DanielMBouyou/AetherArray/hardware/rev-a/erc/erc-report.txt

ERC report (2026-09-18T19:03:25, Encoding UTF8)
Report includes: Errors, Warnings, Exclusions

***** Sheet /

***** Sheet /CH0/

***** Sheet /CH1/

***** Sheet /CH2/

***** Sheet /CH3/

 ** ERC messages: 0  Errors 0  Warnings 0

 ** Ignored checks:
    - Global label only appears once in the schematic
    - Four connection points are joined together
    - SPICE model issue
    - Assigned footprint doesn't match footprint filters
