DanielMBouyou/AetherArray/hardware/rev-a/aetherarray-reva.kicad_sch

## KiCad design hardware/rev-a/aetherarray-reva.kicad_sch (2026-09-18)

Schematic: aetherarray-reva.kicad_sch

Parts:
C900, C903, C905, C907, C908, C909, C910: 100nF
C901, C902: 100pF
C904: 1nF
C906: 220pF
J900: SMA_EL0
J901: SMA_EL1
J902: SMA_EL2
J903: SMA_EL3
J904: SMA_COMMON
J905: NUCLEO_G0_IF
R900, R901, R902: 100R
R903: 18k
R904, R905: 1k
R906, R907: 4k7
TL901, TL902, TL903, TL904, TL905, TL906: QW_70R7
TP900: TP_VOUT
TP901: TP_TEMP
TP902: TP_5V
TP903: TP_3V3
TP904: TP_GND
U900: PE4259-63; MPN PE4259-63
U901: AD8318; MPN AD8318ACPZ
U902, U903: MCP9808; MPN MCP9808T-E/MS

Connections:
+3V3: C900.1, C909.1, C910.1, J905.23 (+3V3), R906.2, R907.2, TP903.1, U900.6 (VDD), U902.8 (V_{DD}), U903.7 (A0), U903.8 (V_{DD})
+5V: C903.1, C904.1, C905.1, J905.22 (+5V), TP902.1, U901.3 (VPSI), U901.4 (VPSI2), U901.9 (VPSO), U901.16 (ENBL)
ADC_DET: C907.1, J905.18 (ADC_DET), R904.2, TP900.1
ADC_TEMP: C908.1, J905.19 (ADC_TEMP), R905.2, TP901.1
AD_INHI: C901.2, U901.14 (INHI)
AD_INLO: C902.1, U901.15 (INLO)
B45_0: J905.5 (B45_0)
B45_1: J905.6 (B45_1)
B45_2: J905.7 (B45_2)
B45_3: J905.8 (B45_3)
B90_0: J905.9 (B90_0)
B90_1: J905.10 (B90_1)
B90_2: J905.11 (B90_2)
B90_3: J905.12 (B90_3)
B180_0: J905.13 (B180_0)
B180_1: J905.14 (B180_1)
B180_2: J905.15 (B180_2)
B180_3: J905.16 (B180_3)
CH0_RF: R901.1, TL903.2 (B)
CH1_RF: R901.2, TL904.2 (B)
CH2_RF: R902.1, TL905.2 (B)
CH3_RF: R902.2, TL906.2 (B)
CLPF_N: C906.1, U901.5 (CLPF)
COM_SMA: J904.1 (In), U900.1 (RF1)
DET_IN: C901.1, U900.3 (RF2)
EL0_RF: J900.1 (In)
EL1_RF: J901.1 (In)
EL2_RF: J902.1 (In)
EL3_RF: J903.1 (In)
EN0: J905.1 (EN0)
EN1: J905.2 (EN1)
EN2: J905.3 (EN2)
EN3: J905.4 (EN3)
GND: C900.2, C902.2, C903.2, C904.2, C905.2, C906.2, C907.2, C908.2, C909.2, C910.2, J900.2 (Ext), J901.2 (Ext), J902.2 (Ext), J903.2 (Ext), J904.2 (Ext), J905.24 (GND), J905.25 (GND2), J905.26 (GND3), R903.2, TP904.1, U900.2 (GND), U901.1 (CMIP), U901.2 (CMIP2), U901.8 (CMOP), U901.11 (CMIP3), U901.12 (CMIP4), U902.4 (GND), U902.5 (A2), U902.6 (A1), U902.7 (A0), U903.4 (GND), U903.5 (A2), U903.6 (A1)
I2C_SCL: J905.20 (I2C_SCL), R907.1, U902.2 (SCL), U903.2 (SCL)
I2C_SDA: J905.21 (I2C_SDA), R906.1, U902.1 (SDA), U903.1 (SDA)
MON_SEL: J905.17 (MON_SEL), U900.4 (CTRL)
NET_COMMON: TL901.1 (A), TL902.1 (A), U900.5 (RFC)
NODE_A: R900.1, TL901.2 (B), TL903.1 (A), TL904.1 (A)
NODE_B: R900.2, TL902.2 (B), TL905.1 (A), TL906.1 (A)
TADJ_N: R903.1, U901.10 (TADJ)
TEMP_N: R905.1, U901.13 (TEMP)
VOUT_N: R904.1, U901.6 (VOUT), U901.7 (VSET)
