DanielMBouyou/AetherArray/hardware/rev-a/rf-channel.kicad_sch

## KiCad design hardware/rev-a/rf-channel.kicad_sch (2026-09-18)

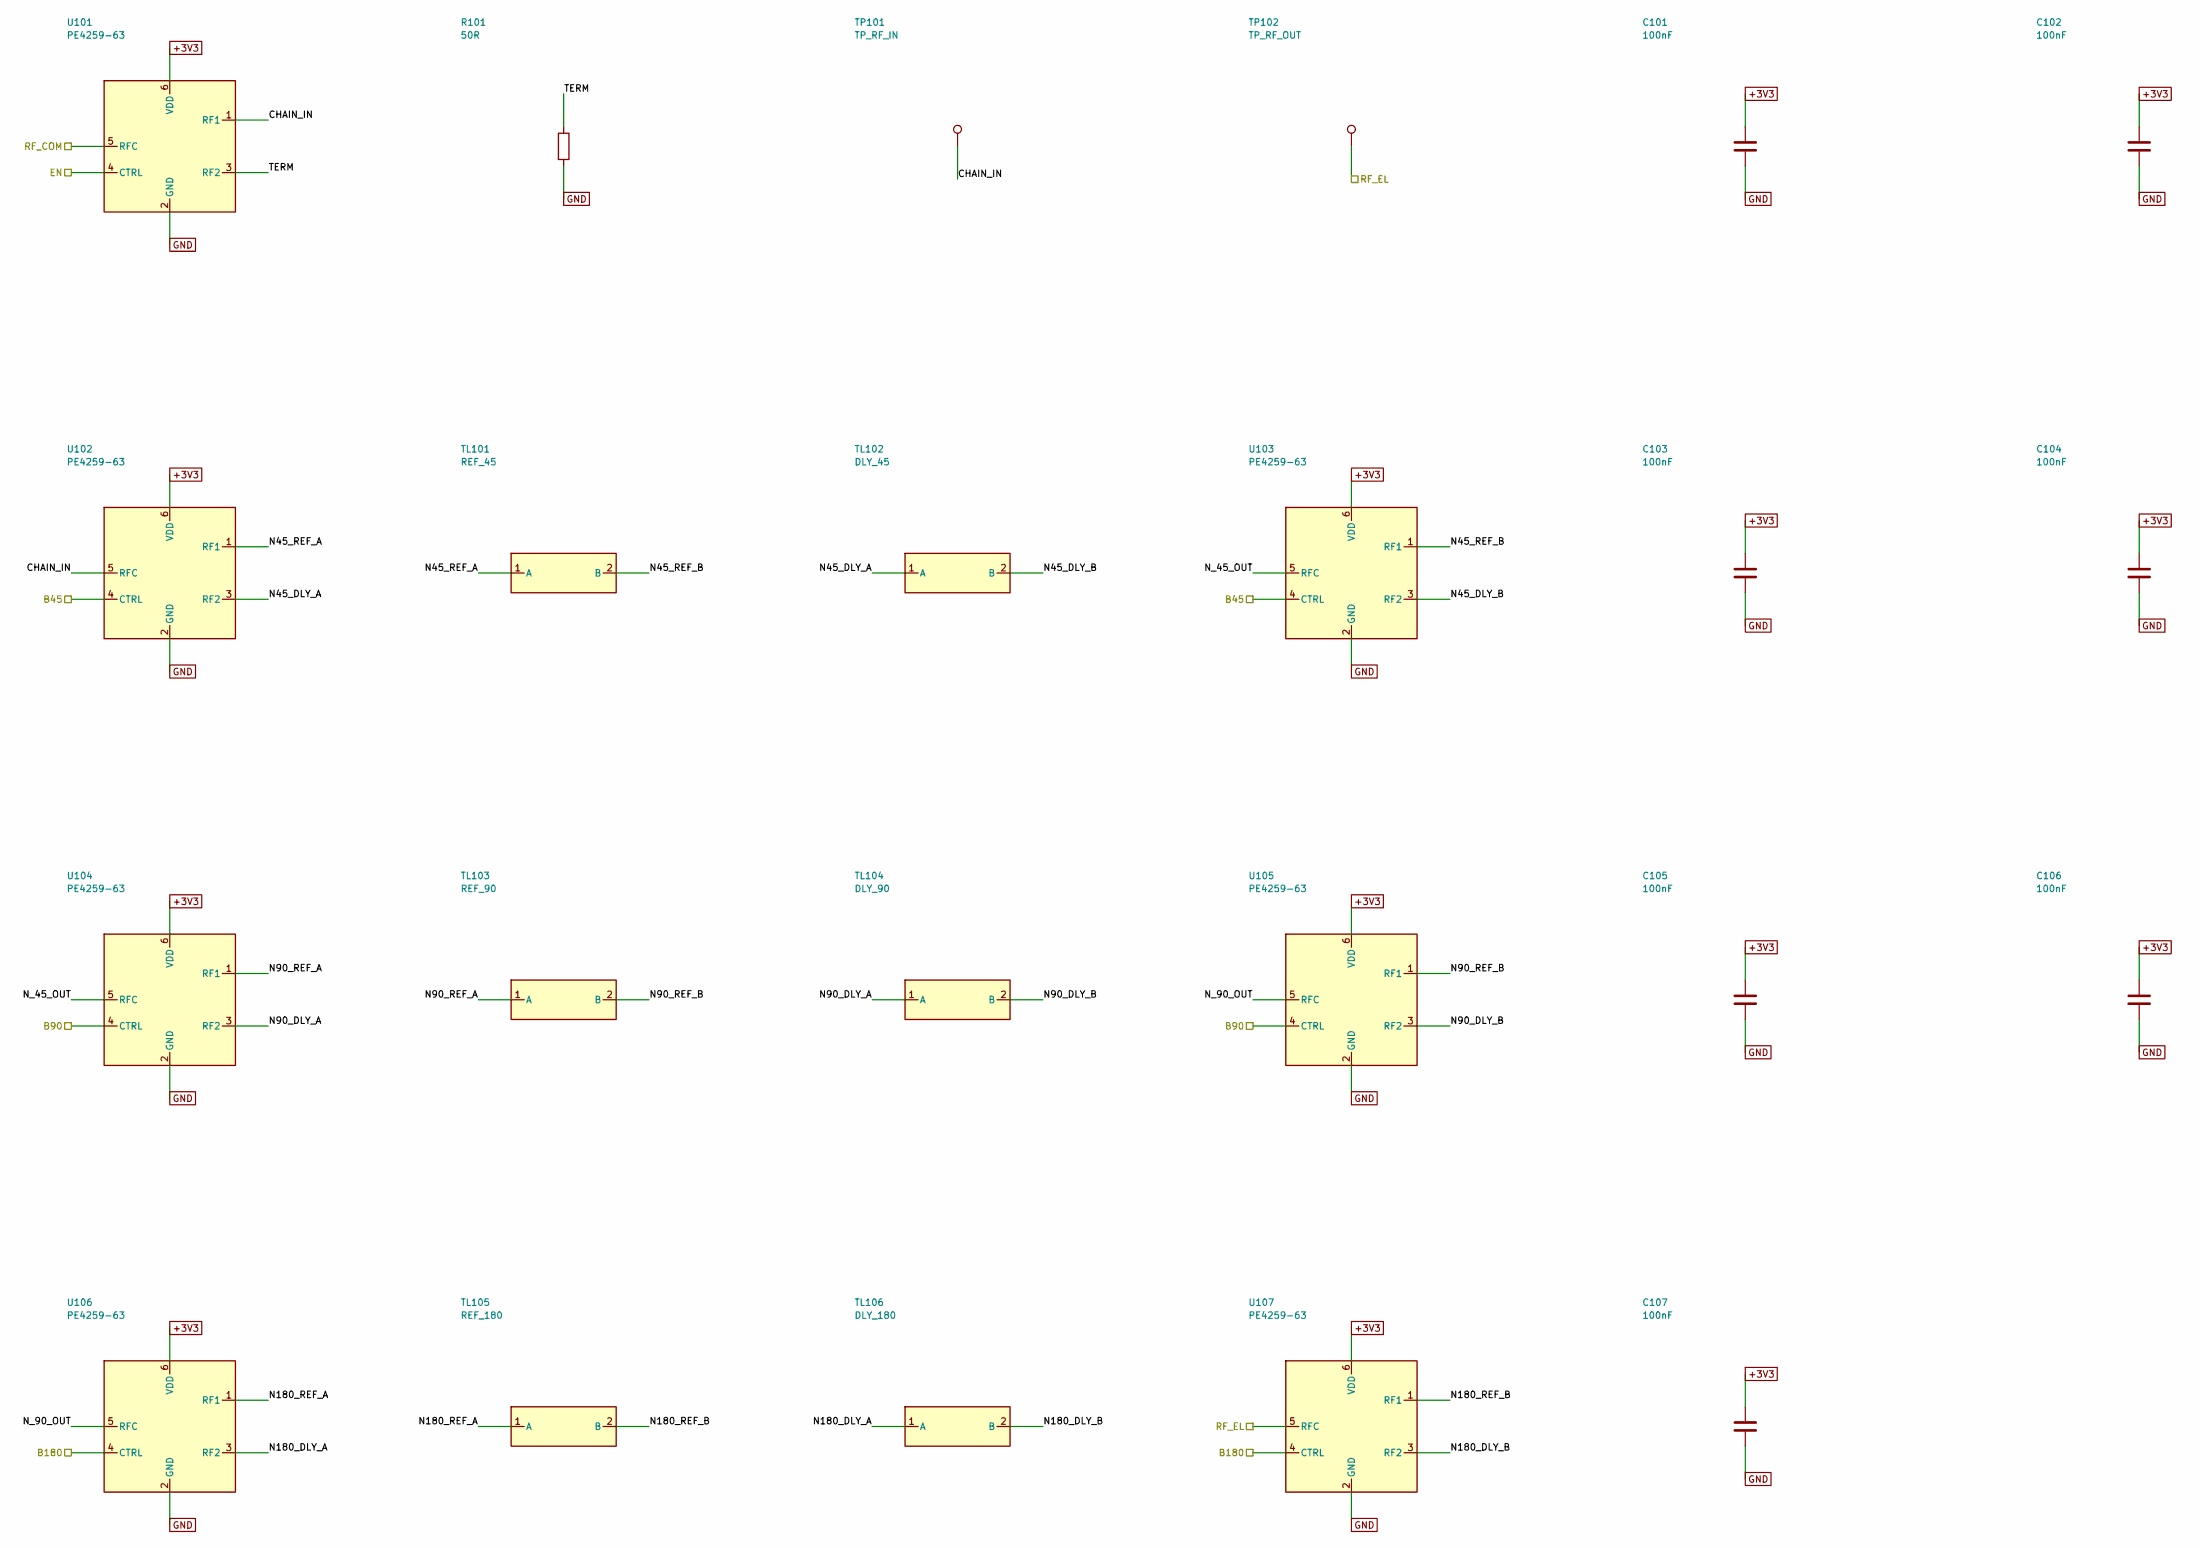
[picture p1: schematic rf-channel.kicad_sch]

Parts:
C101, C102, C103, C104, C105, C106, C107: 100nF
R101: 50R
TL101: REF_45
TL102: DLY_45
TL103: REF_90
TL104: DLY_90
TL105: REF_180
TL106: DLY_180
TP101: TP_RF_IN
TP102: TP_RF_OUT
U101, U102, U103, U104, U105, U106, U107: PE4259-63; MPN PE4259-63

Connections:
+3V3: C101.1, C102.1, C103.1, C104.1, C105.1, C106.1, C107.1, U101.6 (VDD), U102.6 (VDD), U103.6 (VDD), U104.6 (VDD), U105.6 (VDD), U106.6 (VDD), U107.6 (VDD)
B45: U102.4 (CTRL), U103.4 (CTRL)
B90: U104.4 (CTRL), U105.4 (CTRL)
B180: U106.4 (CTRL), U107.4 (CTRL)
CHAIN_IN: TP101.1, U101.1 (RF1), U102.5 (RFC)
EN: U101.4 (CTRL)
GND: C101.2, C102.2, C103.2, C104.2, C105.2, C106.2, C107.2, R101.2, U101.2 (GND), U102.2 (GND), U103.2 (GND), U104.2 (GND), U105.2 (GND), U106.2 (GND), U107.2 (GND)
N45_DLY_A: TL102.1 (A), U102.3 (RF2)
N45_DLY_B: TL102.2 (B), U103.3 (RF2)
N45_REF_A: TL101.1 (A), U102.1 (RF1)
N45_REF_B: TL101.2 (B), U103.1 (RF1)
N90_DLY_A: TL104.1 (A), U104.3 (RF2)
N90_DLY_B: TL104.2 (B), U105.3 (RF2)
N90_REF_A: TL103.1 (A), U104.1 (RF1)
N90_REF_B: TL103.2 (B), U105.1 (RF1)
N180_DLY_A: TL106.1 (A), U106.3 (RF2)
N180_DLY_B: TL106.2 (B), U107.3 (RF2)
N180_REF_A: TL105.1 (A), U106.1 (RF1)
N180_REF_B: TL105.2 (B), U107.1 (RF1)
N_45_OUT: U103.5 (RFC), U104.5 (RFC)
N_90_OUT: U105.5 (RFC), U106.5 (RFC)
RF_COM: U101.5 (RFC)
RF_EL: TP102.1, U107.5 (RFC)
TERM: R101.1, U101.3 (RF2)
