DanielMBouyou/AetherArray/(commit log)

2026-09-18 docs: decide where learning belongs in calibration, and what Rev A must expose
    A counting argument settles the project's central question in the negative for a
    first calibration. At four elements the identifiable unknowns number 2N-2, and
    recovering a complex vector from intensity measurements alone generically needs
    4N-4, which is exactly what the rotating element field vector method consumes at
    its own minimum of three phase states. There is no measurement count left to save.
    What survives is recalibration: a prior learned from the array's own drift history,
    supervised on hardware by a full classical calibration run immediately afterwards.
    Decision 0002 records that reframing, with five g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
2026-09-18 hardware: select the Rev A RF architecture and capture its schematic
    Decision 0003 picks the first board: two boards joined by four per element
    jumpers, four elements, phase control only, and switched line phase shifting at
    three bits of 45, 90 and 180 degrees on PE4259-63.
    Three findings drove it, and none of them is about cost alone.
    Per element access is not an optional extra. The mutual coupling method is the
    only calibration route needing no probe, no positioner and no operator, so it is
    the only one that can produce an unattended dataset, and its single documented
    restriction since 1989 is the ability to transmit and receive on element pairs.
    A board that integrates the splitter with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
    [aetherarray-reva.kicad_sch, preliminary-bom.csv, rf-channel.kicad_sch]
2026-09-19 docs: reduce the Rev A frequency question to one bench reading
    EXP-004 becomes its own experiment, because it now carries the working
    frequency. It is not finished: it is running, and the one observation that
    closes it has not been made.
    Two things were established without the bench.
    No local evidence can identify the instruments. Six avenues were tried: the
    consolidated inventory, installed instrument software, the instrument control
    library, the operating system record of every device ever attached by USB, the
    instrument class driver, and saved Touchstone files. All empty. The analyser has
    never been connected to this computer. The negative result is recorded so the
    search is not repeate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
2026-09-21 docs: record the measurement bench, and what is still inference
    A vector network analyser was observed on the bench: 50 ohm, 9 kHz to 3 GHz, N
    female ports, transmission and complex formats, source up to 0 dBm, USB present.
    That answers the question the working frequency was waiting on. It does not close
    EXP-004, which stays running.
    The instrument is not in the documented laboratory inventory, and none of the four
    instruments that inventory does list has been confirmed to be physically present.
    So the bench architecture is built so the observed analyser alone is sufficient,
    and every cross check is marked conditional. The only cross checks that do not
    depend on an unconfirmed instrument ar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
2026-09-23 docs: freeze the working frequency, move to an external controller, pose the calibration as an inverse problem
    Three architecture decisions and their consequences, committed together because
    they are one coherent change to how Rev A is driven and measured.
    Decision 0004 fixes the working frequency at 2.44 GHz. It corrects a closure rule
    rather than adding evidence: an earlier version held the frequency open until the
    analyser's exact model had been read and checked against a datasheet. That
    confused two kinds of evidence. A datasheet says what a manufacturer specifies for
    a family; a bench observation says what the unit in the room does. For the question
    asked, whether this instrument reach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
2026-09-25 docs: make EXP-005 a bench-executable protocol that decides R9 and H3
    Decision 0005 adopted the deterministic quiet window and the converter on the
    radio frequency board as precautions, and said so. This turns both into
    measurements, with decision rules fixed before any data exists. The commit is the
    timestamp: a rule may be found unusable, in which case the experiment is redone,
    but no rule is retuned against a number.
    Two observations shaped the design.
    The detector is not needed. What R9 and H3 concern is the acquisition path, and the
    detector is only a source of a slowly varying voltage in the range the converter
    will see. A stable direct source stands in for it, and is better for the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
2026-09-25 docs: record EXP-005 preparation, and that C1 has not been run
    Carried over from the C1 session. Two of the five pre-start items are lookups
    rather than bench work, so they were done away from the instrument.
    Item B1, the analogue input path, is advanced but not closed, and advancing it
    surfaced something worth catching before anything is wired. The converter has a
    2.5 V internal reference, yet the header range is quoted as 0 V to 4.096 V.
    Those two are only compatible if a network sits between them, either an external
    reference or attenuation. If it is a divider, the impedance the sampling
    capacitor sees is the divider's output impedance rather than the source's, so a
    source that is stiff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
2026-09-25 tools: make scikit-rf the shared RF data layer
    One path from every producer of S parameters to every consumer of them. The
    electromagnetic solver, the circuit simulator and the analyser all export
    Touchstone; rfkit turns that into comparisons, the array state the inverse
    problem infers, and the dataset records the inference will read.
    A library rather than a script per task, because the project compares three
    things that are easy to compare wrongly. Comparing traces over a range only one
    of them covers, or calling the difference between 359 and 1 degrees 358 degrees,
    produces a plausible number and a wrong conclusion, and neither announces
    itself. The rules that prevent both now live in one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
2026-09-25 docs: stage purchases by what they unblock, and reconcile tracking with the baseline
    The ordering rule was written in five places and had become circular. It said
    nothing is bought before gate G2 is answered, and that G2 is answerable with
    instruments already owned. Neither premise holds any more. EXP-005 Phase B needs a
    detector, antennas and interconnect that nobody owns, and the drift half of G2,
    EXP-010, is a property of the built array. Read literally, the rule forbade the
    Phase B purchases that measure the floor, and the Rev A order permanently.
    Decision 0006 stages purchases in four classes: zero purchase, measurement
    enabling, Rev A fabrication, and optional upgrades, each gated onl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
2026-09-26 tools: derive provisional RF acceptance thresholds from the quantisation floor
    The five rfkit verdict metrics had no values, and the error budget meant to
    supply them sat unfinished and untracked. This completes it.
    No pointing target exists anywhere in the repository, so the anchor is the one
    array level error an accepted decision fixes: the three bit quantisation of
    decision 0003, 12.99 degrees rms per channel, which costs 1.85 degrees of
    pointing spread and 0.167 dB of coherent gain whatever the calibration does. A
    discrepancy is accepted when, in its most damaging arrangement, it adds at most
    a declared fraction eta = 0.10 of that floor's error variance to pointing, gain
    and the error s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
2026-09-26 docs, tools: pre-register gate G4 as a model adequacy test for coupling
    Gate G4 asked whether coupling is significant at the chosen spacing and defined
    no test. Decision 0008 fixes one before any coupling has been simulated or
    measured, and rfkit.coupling implements it.
    The quantities are separated the way the two board split allows. Antenna port
    mutual coupling is the off diagonal of the antenna board's matrix at the
    element connectors. Beamformer path crosstalk acts through the output match and
    isolation of the other board, and only together with the antennas'
    reflections. Forward crosstalk is a state dependent diagonal error and stays
    with decision 0007.
    The coupled forward model cascad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
2026-09-26 docs, tools: separate local work from school work, with a runbook for every school task
    Some of the work can only happen at school, where the network analyser, the full
    HFSS licence and ADS are. This makes that distinction permanent and gives every
    school task a procedure that can be opened at the machine days later and
    followed without reconstructing the project.
    docs/runbooks/README.md classifies every action as LOCAL, SCHOOL-SOFTWARE,
    SCHOOL-BENCH or EITHER, by four rules. Work runs where it is scientifically
    sufficient, not where the most powerful tool is. HFSS Student is the default HFSS
    path: its manufacturer documented limits for 2025 R1, 64,000 volume elements
    among them, are record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
2026-09-28 docs: rewrite every README in plain, direct language
    The main README still described the project as it stood in August: the frequency,
    the kind of wave and the controller were all open, and it said nothing about the
    tools. It now explains the whole project to someone arriving cold. That covers
    the array and its question, the first board part by part with the reason for
    each, what HFSS, HFSS Student, PyAEDT, ADS, scikit-rf, rfkit, the analyser,
    KiCad and the DE1-SoC each do and where each one runs, how the work is
    organised, the eight decisions so far, where things stand, and the commands that
    need no licence and no instrument.
    The other ten READMEs keep every table, code block and heading e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
2026-10-03 docs, tools, hardware: select the Rev A stack-up and make SIM-001 ready
    - Decision 0009: JLCPCB 4 layer FR-4 JLC04161H-7628 for the beamformer, RF on L1
    over L2; JLCPCB 2 layer 1.6 mm FR-4 for the antennas; mask opened over RF copper;
    smooth copper with a bounded loss study; coupons on each board calibrate the model.
    - One canonical stack-up, hardware/rev-a/stackup/reva-stackup.json, every value with
    unit, status and source; rejected candidates kept as evidence.
    - rfkit.stackup: validation, initialisation-only seeds, tolerance sensitivity, loss and
    patch sanity checks, SIM-001 inputs, generated documentation tables checked by tests;
    stack-up fingerprint carried in trace provenance.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
